Ken-2511/desk-timer/fabrication/desk-timer-2026-10-18/checks/drill-report.txt

Drill report for desk-timer.kicad_pcb
Created on 2026-10-18T17:25:00

Copper Layer Stackup:
    =============================================================
    L1 :  F.Cu                      front
    L2 :  B.Cu                      back

Drill file 'desk-timer-PTH.drl' contains
    plated through holes:
    =============================================================
    T1  0.400mm  0.0157"  (5 holes))
    T2  0.900mm  0.0354"  (12 holes))
    T3  1.000mm  0.0394"  (40 holes))

    Total plated holes count 57

Drill file 'desk-timer-NPTH.drl' contains
    unplated through holes:
    =============================================================
    T1  3.200mm  0.1260"  (4 holes))

    Total unplated holes count 4
