Ken-2511/desk-timer/desk-timer.kicad_pcb

## KiCad design desk-timer.kicad_pcb (2026-10-18)

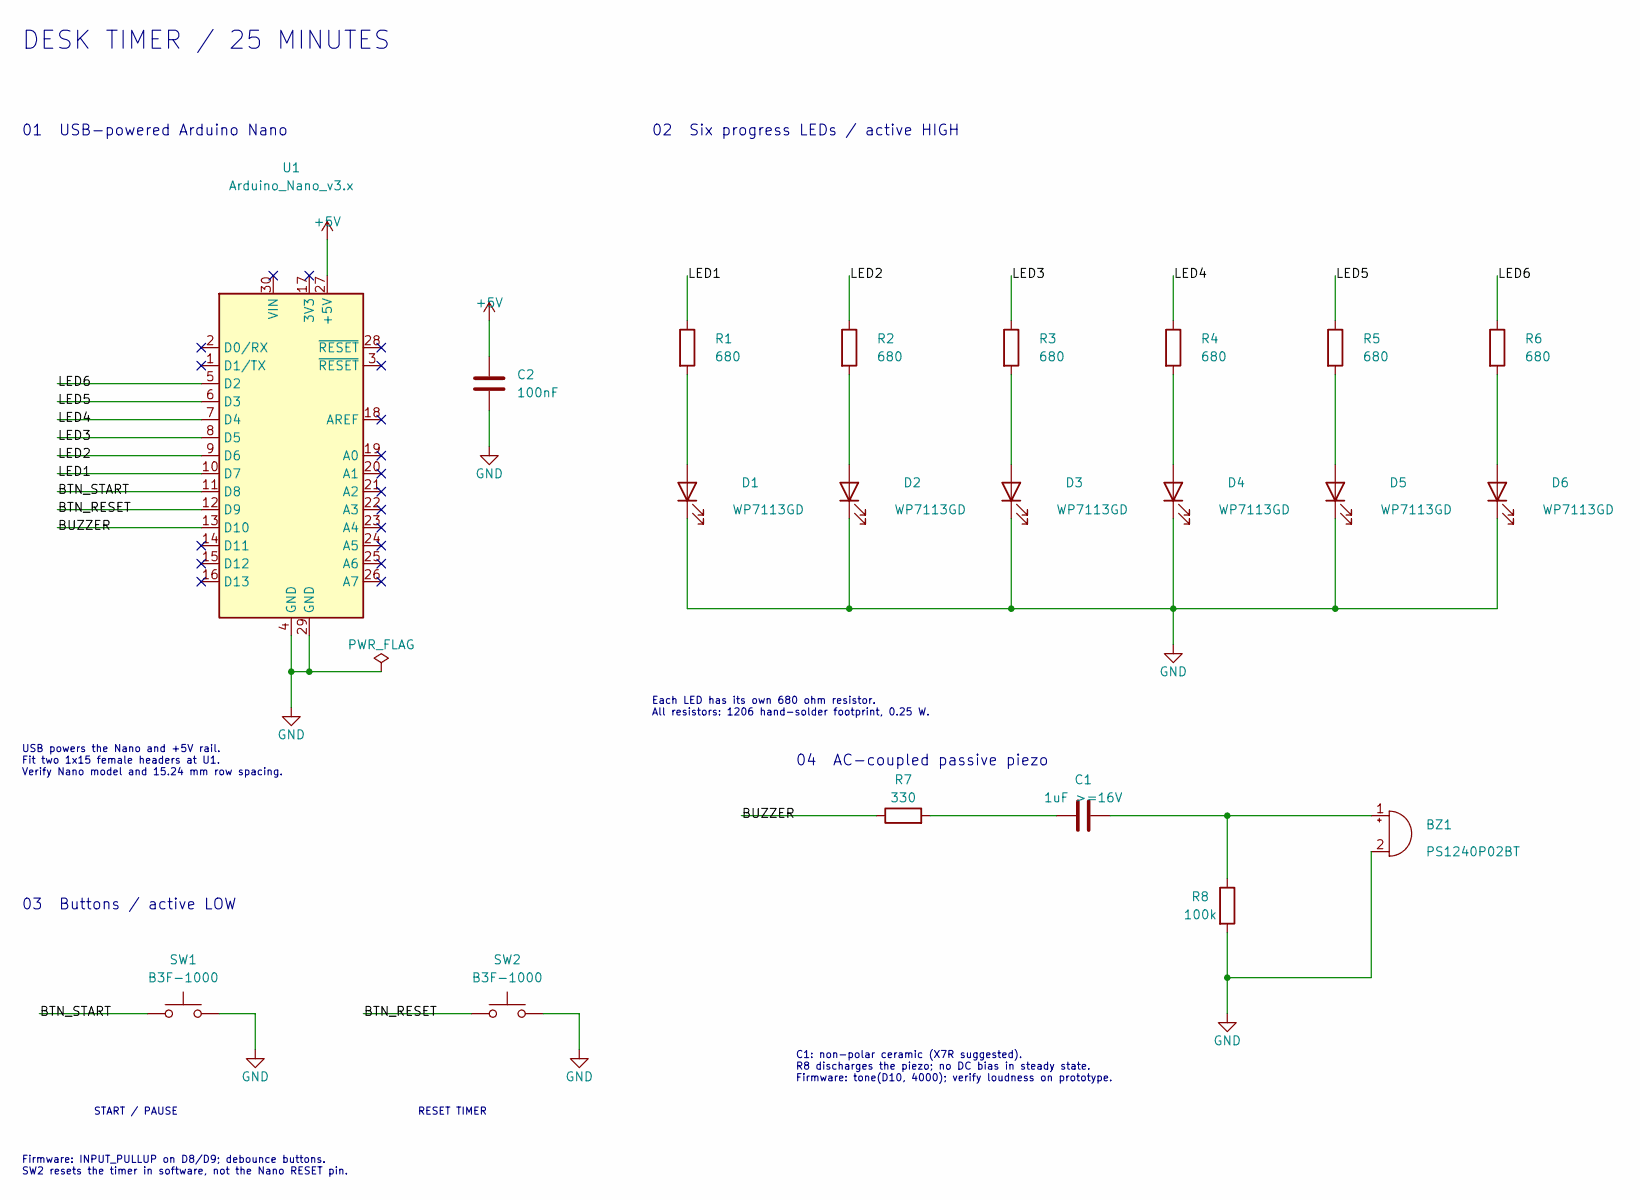
[picture p1: schematic desk-timer.kicad_sch, Desk Timer - 25 minute focus timer]

Parts:
BZ1: PS1240P02BT; Buzzer_TDK_PS1240P02BT_D12.2mm_H6.5mm
C1: 1uF >=16V; C_1206_3216Metric_Pad1.33x1.80mm_HandSolder
C2: 100nF; C_1206_3216Metric_Pad1.33x1.80mm_HandSolder
D1, D2, D3, D4, D5, D6: WP7113GD; LED_D5.0mm
R1, R2, R3, R4, R5, R6: 680; R_1206_3216Metric_Pad1.30x1.75mm_HandSolder
R7: 330; R_1206_3216Metric_Pad1.30x1.75mm_HandSolder
R8: 100k; R_1206_3216Metric_Pad1.30x1.75mm_HandSolder
SW1, SW2: B3F-1000; SW_TH_Tactile_Omron_B3F-100x
U1: Arduino_Nano_v3.x; Arduino_Nano

Connections:
+5V: C2.1, U1.27 (+5V)
/BTN_RESET: SW2.1, U1.12 (D9)
/BTN_START: SW1.1, U1.11 (D8)
/BUZZER: R7.1, U1.13 (D10)
/LED1: R1.1, U1.10 (D7)
/LED2: R2.1, U1.9 (D6)
/LED3: R3.1, U1.8 (D5)
/LED4: R4.1, U1.7 (D4)
/LED5: R5.1, U1.6 (D3)
/LED6: R6.1, U1.5 (D2)
GND: BZ1.2 (-), C2.2, D1.1 (K), D2.1 (K), D3.1 (K), D4.1 (K), D5.1 (K), D6.1 (K), R8.2, SW1.2, SW2.2, U1.4 (GND), U1.29 (GND)
unnamed: BZ1.1 (+), C1.2, R8.1
unnamed: C1.1, R7.2
unnamed: D1.2 (A), R1.2
unnamed: D2.2 (A), R2.2
unnamed: D3.2 (A), R3.2
unnamed: D4.2 (A), R4.2
unnamed: D5.2 (A), R5.2
unnamed: D6.2 (A), R6.2

Notes on the sheet:
DESK TIMER / 25 MINUTES
01 USB-powered Arduino Nano
USB powers the Nano and +5V rail. Fit two 1x15 female headers at U1. Verify Nano model and 15.24 mm row spacing.
02 Six progress LEDs / active HIGH
Each LED has its own 680 ohm resistor. All resistors: 1206 hand-solder footprint, 0.25 W.
03 Buttons / active LOW
START / PAUSE
RESET TIMER
Firmware: INPUT_PULLUP on D8/D9; debounce buttons. SW2 resets the timer in software, not the Nano RESET pin.
04 AC-coupled passive piezo
C1: non-polar ceramic (X7R suggested). R8 discharges the piezo; no DC bias in steady state. Firmware: tone(D10, 4000); verify loudness on prototype.

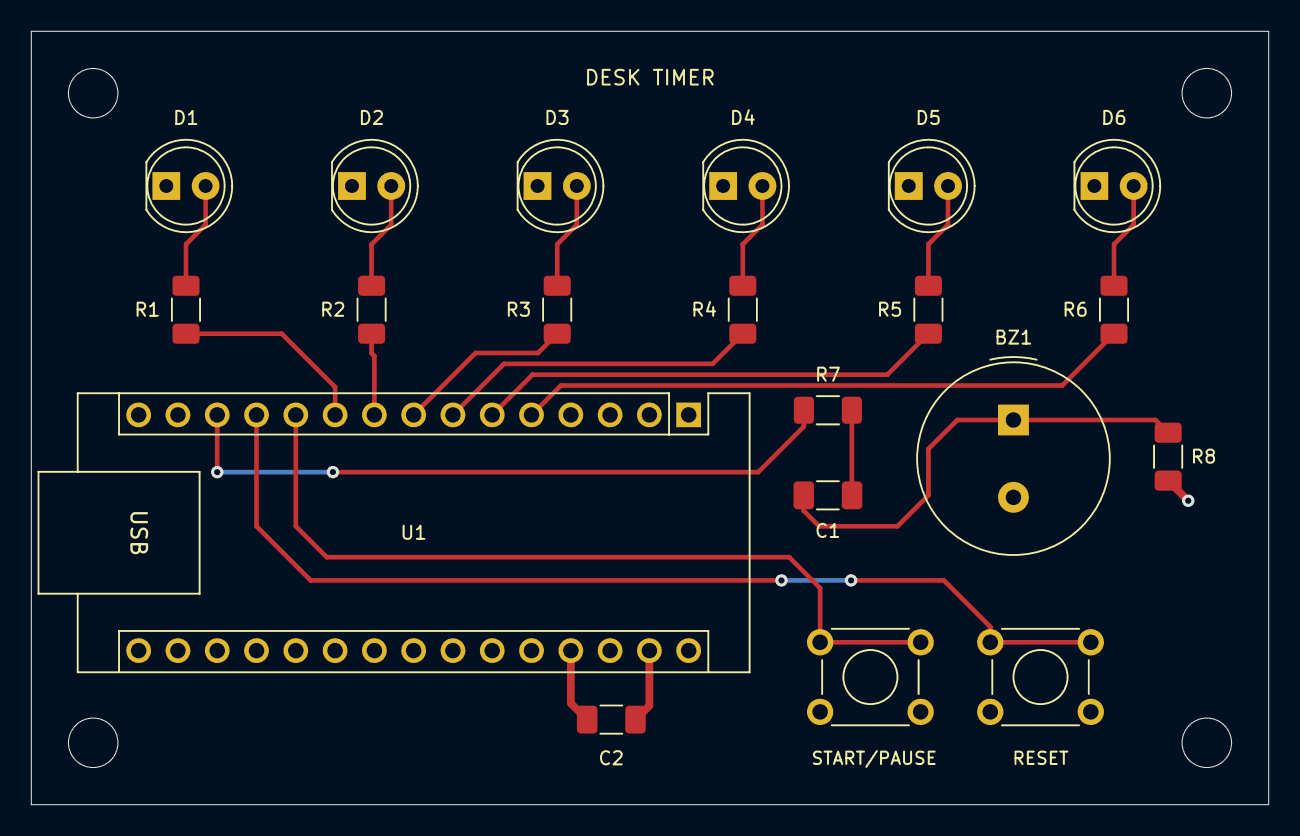
[picture p2: board desk-timer.kicad_pcb from above]

Board: 2 copper layers, 80.0 x 50.0 mm, 24 parts (0 on the bottom side), 19 nets.

Other parts of the board:
H1, H2, H3, H4: MountingHole_3.2mm_M3
