Ken-2511/desk-timer/(commit log)

2026-10-18 Initialize KiCad desk timer project
    [desk-timer.kicad_pcb, desk-timer.kicad_sch]
2026-10-18 Add wired desk timer schematic and project documentation
    [desk-timer.kicad_sch]
2026-10-18 Complete desk timer PCB layout and routing
    [desk-timer.kicad_pcb, desk-timer.kicad_sch]
2026-10-18 Archive validated PCB fabrication package
    [desk-timer.kicad_pcb]
2026-11-01 Add Arduino smoke test and desk timer firmware
    smoke-test runs an LED chaser and checks both buttons and the buzzer.
    desk-timer is a binary-display countdown with six selectable lengths,
    a repeating alarm with a 10-minute cap, and a 3 s display timeout.
    [desk-timer.ino, smoke-test.ino]
